Ibere22/Table-Tennis-Machine/(commit log)

2025-10-24 Add ESP32 table tennis ball launcher code
2025-12-06 Clean repository structure: Add README, ESP32 firmware, and Android app source files
